MatheusADC/Minidrone/README.md

# Ícone de descrição Descrição
O projeto tem como objetivo o desenvolvimento de um minidrone, abrangendo desde a elaboração do **circuito elétrico** e a confecção da **placa principal**, até a implementação do código em **C++** e a impressão e montagem do **chassi**.

<div align="center">

| Minidrone |
| --------- |
|  |

</div>

# Ícone de componentes Componentes
- 1 x ESP32-S3
- 1 x Módulo GY-521 MPU-6050
- 4 x Transistor MOSFET SI2300 SOT-23 SMD
- 4 x Diodo 1N4148 SOD-323 SMD
- 4 x Capacitor 100nF 50V 0805 SMD 
- 6 x Resistor 0805 SMD 912 (9.1 kOhms)
- 4 x Motor com hélice 
- 1 x Conector JST 2pinos curvo
- 1 x Bateria LiPO 3.7v 250mAh
- 1 x Pasta de solda 15g (138ºC)
- Percloreto de Ferro
- Placa de Fenolite

# <sub>Ícone de placa</sub> Processo de Manufatura da Placa Principal
1. **Corte** um pedaço de placa de fenolite nas dimensões desejadas.
2. Faça a limpeza da superfície utilizando **palha de aço**.
3. Imprima o arquivo da [PCB](https://github.com/MatheusADC/Minidrone/blob/main/PCB.pdf).
4. **Fixe** a folha impressa na placa com fita crepe, garantindo que o lado impresso fique em contato direto com a face limpa da placa.
5. Aplique **acetona** sobre o papel e pressione-o firmemente contra a placa por aproximadamente **10 minutos**.
6. Aguarde a acetona **evaporar**, isto é, a tinta da impressão do circuito no papel A4 ficar quase imperceptível.
7. Remova **cuidadosamente** o papel sob água corrente.
8. Faça a limpeza da superfície utilizando **palha de aço**.
9. Prenda um **barbante** na placa utilizando fita crepe, para facilitar o manuseio.
10. Mergulhe a placa em **percloreto férrico**, sem encostá-la no fundo do recipiente, por cerca de **10 a 15 minutos**.

<div align="center">

| Resultado |
| --------- |
| Placa com as trilhas |

</div>

> [!CAUTION]
> O percloreto de ferro é responsável por corroer a camada de cobre da placa.
> Portanto, evite deixá-la imersa por tempo excessivo.
>
> Um indicativo de **excesso de corrosão** é o surgimento de manchas de **coloração rosa** na superfície da placa.

9. Utilize um **furador manual para placas de fenolite** a fim de realizar os furos necessários para a passagem dos fios e do conector da bateria.

# Ícone de ferro de solda Microsoldagem
- Para soldar os componentes recomenda-se utilizar a **pasta de solda**.
- Para os **fios** e o **conector JST** recomenda-se usar o estanho em fio.
  
| Solda dos componentes | Solda dos fios |
| --- | ---|
| Solda dos componentes | Solda dos fios |

> [!TIP]
> Para faciliar a solda dos componentes eletroeletrônicos pode-se utilizar uma **mesa para solda**.

# Ícone de multímetro Testes do Circuito Elétrico

## Teste de Continuidade da Trilha

1. Ajuste o multímetro para o **modo diodo**.

<div align="center">

| Teste de Continuidade |
| --------------------- |
| Teste de continuidade da trilha |

</div>

2. Ao posicionar as ponteiras do multímetro sobre um trecho **contínuo da trilha**, o equipamento emitirá um **sinal sonoro** característico, indicando condução elétrica.

3. Caso seja detectada continuidade elétrica entre trilhas que **não deveriam estar conectadas**, recomenda-se utilizar um **estilete** para realizar um pequeno corte na junção entre elas. Em seguida, repita o teste para confirmar a **descontinuidade** elétrica.

## Teste de Resistência Elétrica

1. Ajuste o multímetro para o **modo ohmímetro 20kΩ**.

<div align="center">

| Teste de Resistência |
| -------------------- | 
| Teste de Resistência Elétrica |

</div>

2. Ao posicionar as ponterias do multímetro nas extremidades de um resistor, o valor exibido no _display_ do multímetro deve ser próximo de **912**.

<!--# <sub><img src="https://img.icons8.com/?size=100&id=hJkVmtuljaPn&format=png&color=000000" alt="Ícone de circuito elétrico" width="38"></sub>Soldagem entre placas-->

# <sub>Ícone do Arduino</sub> Configurações do Arduino IDE 
1. Adicione o repositório oficial da Espressif em **File > Preferences > Additional boards manager URLs > OK**.
```
https://raw.githubusercontent.com/espressif/arduino-esp32/gh-pages/package_esp32_index.json
```
| Adição da URL do Repositório |
| ---------------------------- |
|  |

2. Instale o **Gerenciador de Placas** da família ESP32.
   
| Gerenciador de Placas ESP32 |
| --------------------------- |
|  |

3. Escolha o ESP32S3 como placa padrão em **Tools > Board > esp32 > ESP32S3 Dev Module**.

| Placa padrão |
| ------------ |
|  |

4. Determine a porta de conexão do computador com a placa ESP32S3 pelo USB em **Tools > Port**.

| Determinação da porta |
| --------------------- |
|  |

# <sub>Ícone de Minidrone</sub> Resultado

<div align="center">
  
| Vista Superior | Vista Inferior |
| --- | --- |
| Vista Superior | Vista Inferior |

| Vista Isométrica | Porção Interna |
| --- | --- |
| Vista Isométrica | Porção Interna |

</div>
