MatheusADC/Minidrone/BOM_Board1_PCB1_2026-01-03.xlsx

No. | Quantity | Comment | Designator | Footprint | Value | Manufacturer Part | Manufacturer | Supplier Part | Supplier
1 | 4 | 100nF | C1,C2,C3,C4 | C0805 | 100nF | 0805B104K500P | Knowles(楼氏) | C1621700 | LCSC
2 | 4 | 1N4148WX | D1,D2,D3,D4 | SOD-323_L1.6-W1.3-LS2.7-RD |  | 1N4148WX | YONGYUTAI(永裕泰) | C19089391 | LCSC
3 | 5 | PZ254V-11-01P | H1,H3,H5,H7,H9 | HDR-TH_1P-P2.54-V-M |  | PZ254V-11-01P | XFCN(兴飞) | C492400 | LCSC
4 | 7 | PZ254V-11-02P | H2,H4,H6,H8,H10,H11,H12 | HDR-TH_2P-P2.54-V-M |  | PZ254V-11-02P | XFCN(兴飞) | C492401 | LCSC
5 | 4 | SI2300 | Q1,Q2,Q3,Q4 | SOT-23-3_L2.9-W1.3-P0.95-LS2.4-BR |  | SI2300 | PAKER(派克微) | C5278895 | LCSC
6 | 6 | 10kΩ | R1,R2,R3,R4,R5,R6 | R0805 | 10kΩ | ACR0805J0R | VO(翔胜) |  | LCSC
