MatheusADC/Minidrone/SCH_Schematic1_2026-01-03.pdf

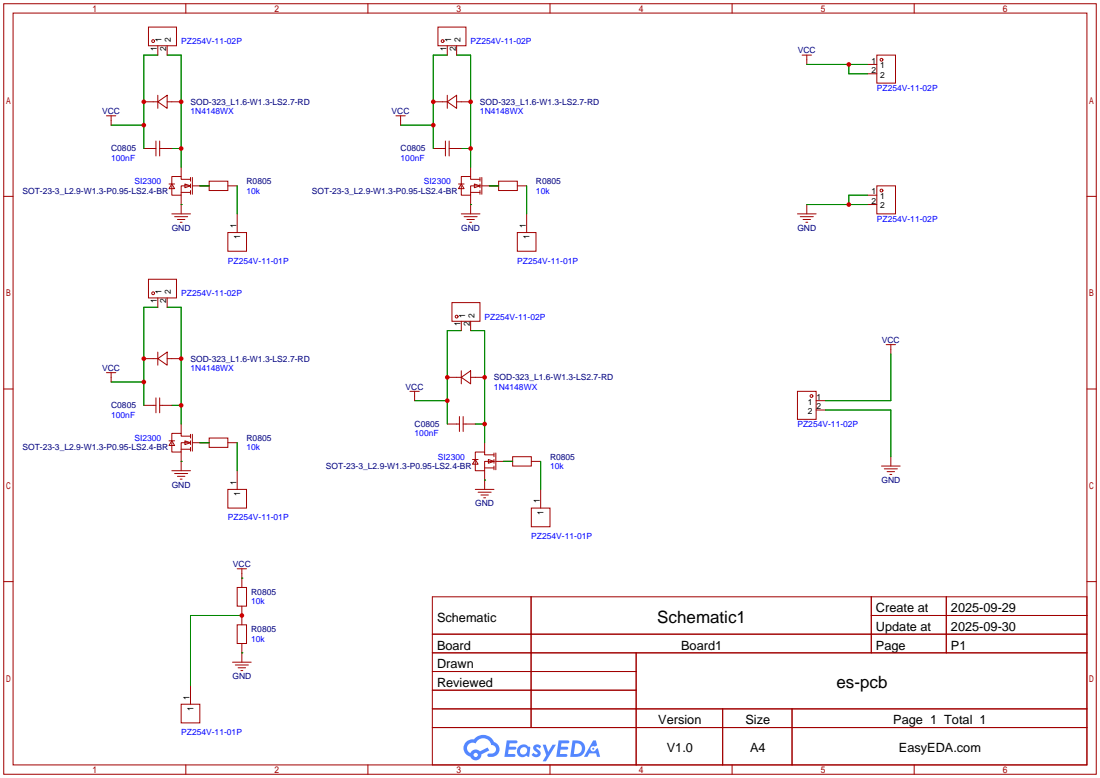
[picture p1: page 1]

Schematic | Schematic1 | Create at | 2025-09-29

Update at | 2025-09-30

Board | Board1 | Page | P1
Drawn | | es-pcb
Reviewed

Version | Size | Page 1 Total 1
V1.0 | A4 | EasyEDA.com
