MatheusADC/Minidrone/PCB.pdf

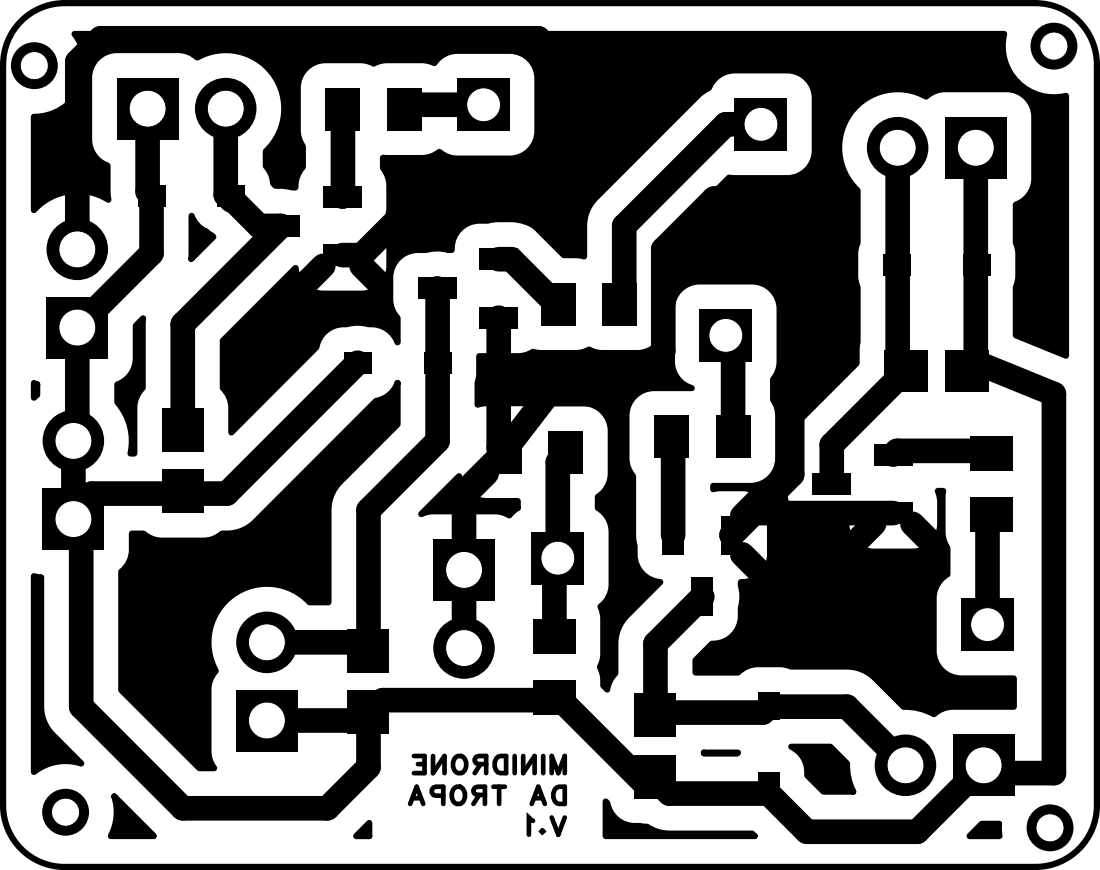
[picture p2: page 1]
