MatheusADC/Minidrone/(commit log)

2025-12-17 add: PCB black/white
2026-01-03 add: Gerber
2026-01-03 add: Bill of Materials
    [BOM_Board1_PCB1_2026-01-03.xlsx]
